adentan679/PinballMachine/hardware/cad/flipper_CAD.JPG

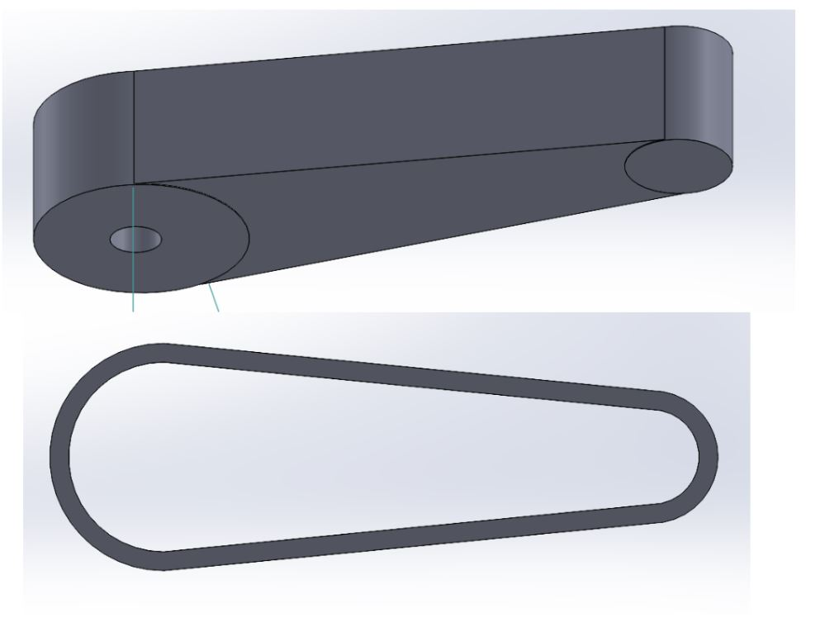
hardware/cad/flipper_CAD.JPG
