adentan679/PinballMachine/hardware/cad/flipper_design.JPG

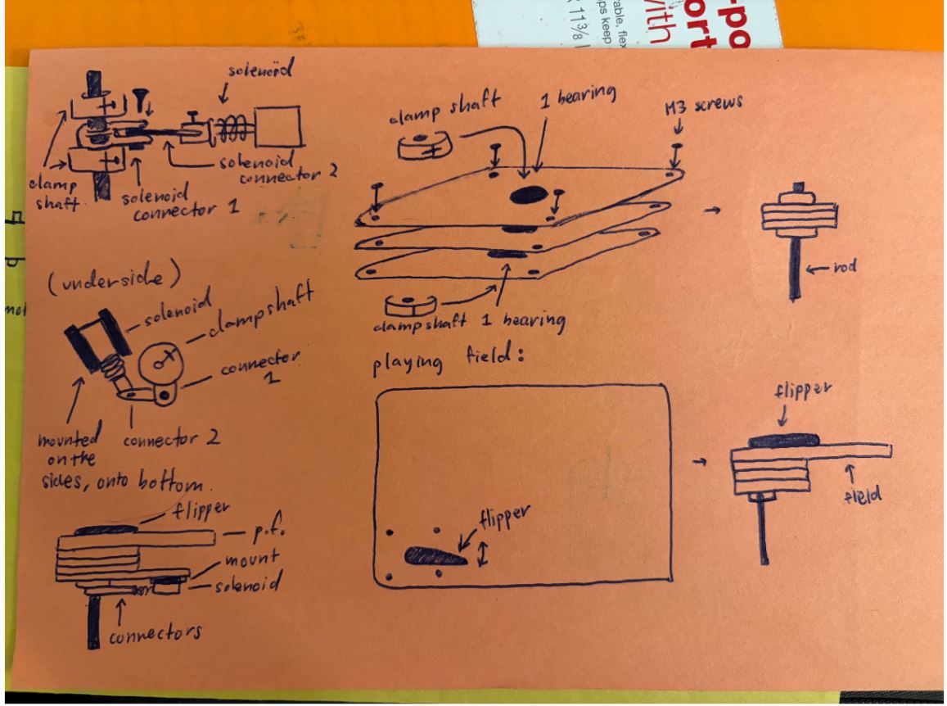
hardware/cad/flipper_design.JPG
