adentan679/PinballMachine/hardware/cad/full_cad_schematic.JPG

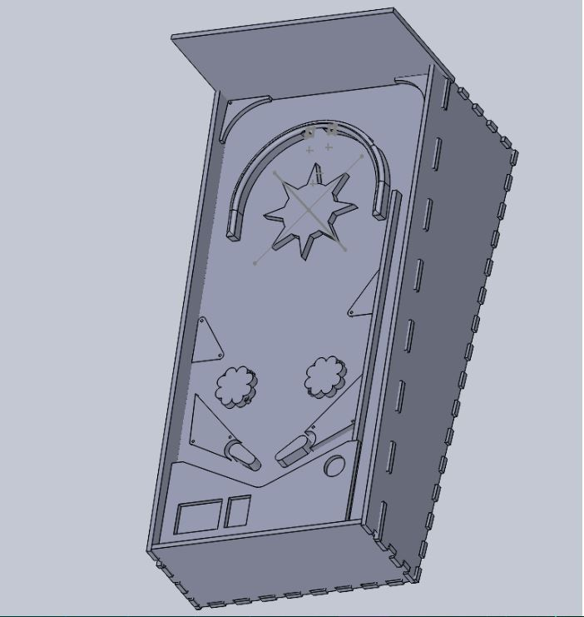
hardware/cad/full_cad_schematic.JPG
