adentan679/PinballMachine/hardware/cad/piezo_sensor_CAD.JPG

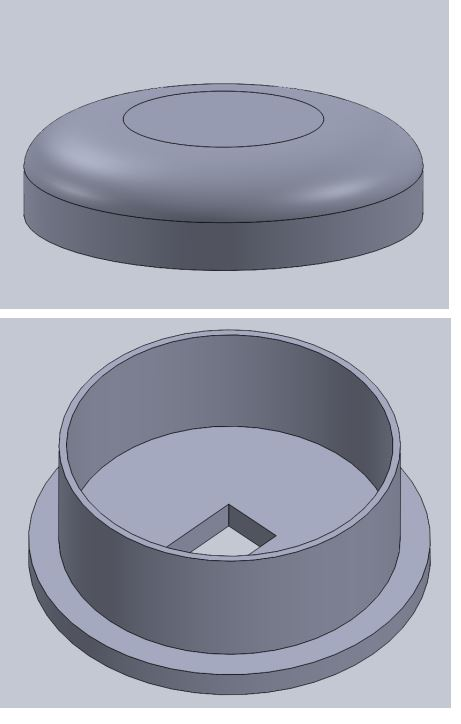
hardware/cad/piezo_sensor_CAD.JPG
