adentan679/PinballMachine/hardware/cad/solenoid_connection.JPG

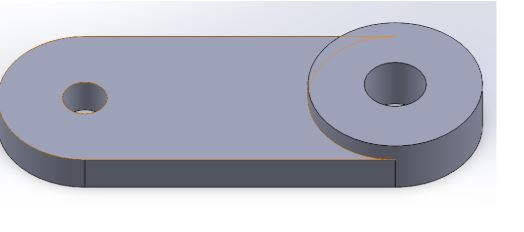
hardware/cad/solenoid_connection.JPG
