adentan679/PinballMachine/hardware/circuit_diagrams/gear_motor_diagram.JPG

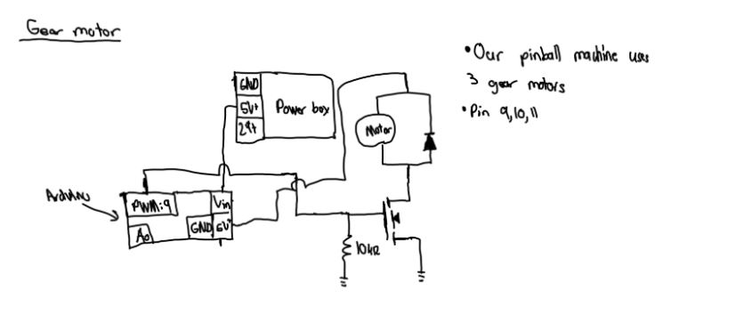
hardware/circuit_diagrams/gear_motor_diagram.JPG
