adentan679/PinballMachine/hardware/circuit_diagrams/IR_sensor_points_diagram.JPG

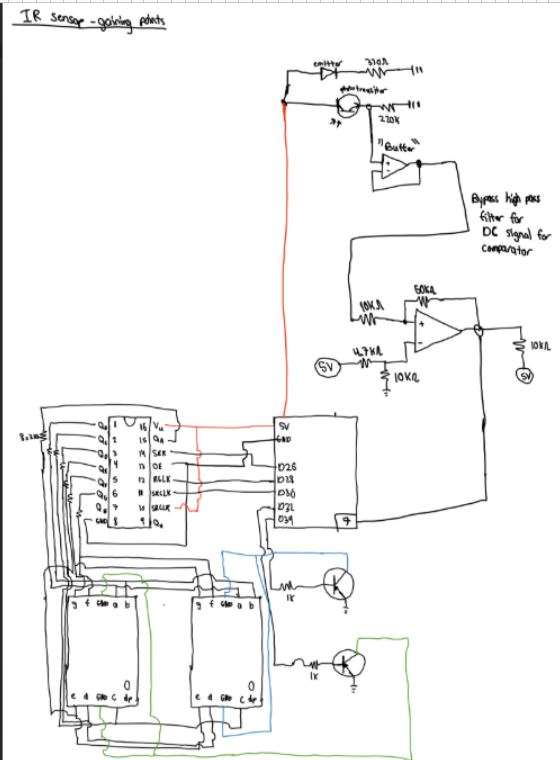
hardware/circuit_diagrams/IR_sensor_points_diagram.JPG
