adentan679/PinballMachine/hardware/circuit_diagrams/loss_sensor_diagram.JPG

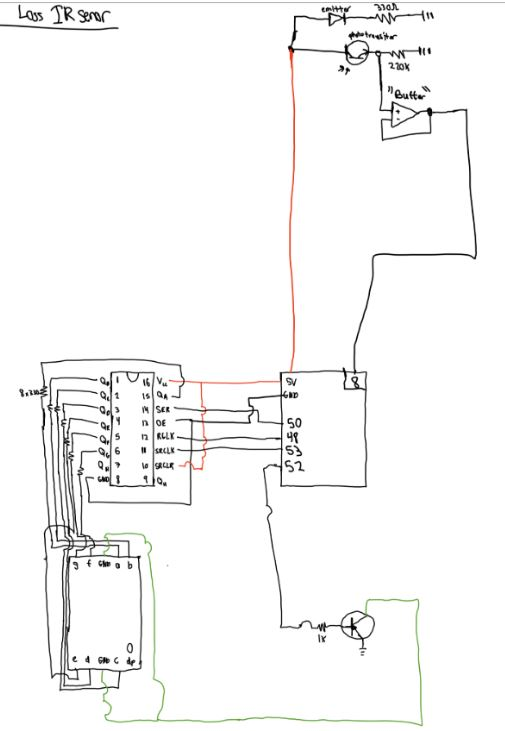
hardware/circuit_diagrams/loss_sensor_diagram.JPG
