adentan679/PinballMachine/hardware/circuit_diagrams/piezo_sensor_diagram.JPG

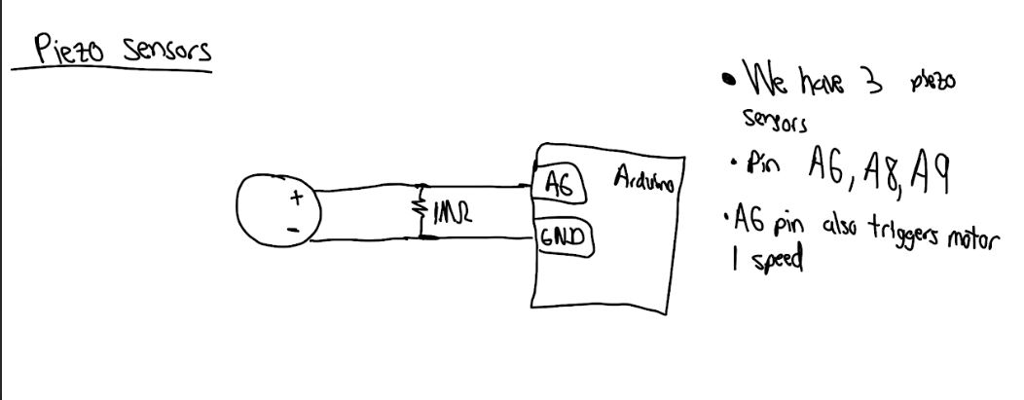
hardware/circuit_diagrams/piezo_sensor_diagram.JPG
