adentan679/PinballMachine/hardware/circuit_diagrams/servo_gate_diagram.JPG

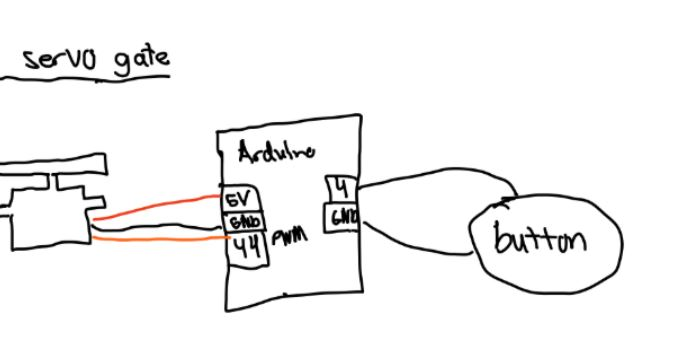
hardware/circuit_diagrams/servo_gate_diagram.JPG
