adentan679/PinballMachine/hardware/circuit_diagrams/solenoid_diagram.JPG

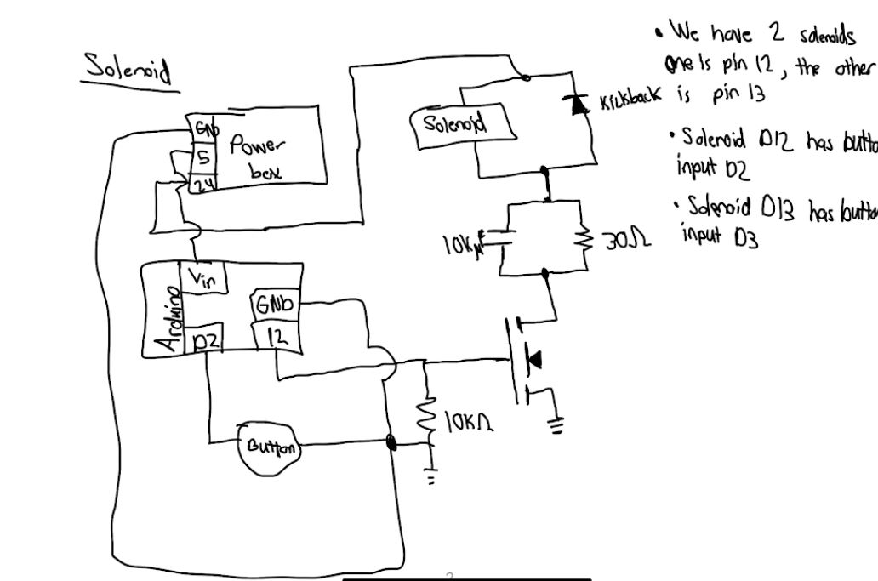
hardware/circuit_diagrams/solenoid_diagram.JPG
