adentan679/PinballMachine/media/final_project_pic.jpg

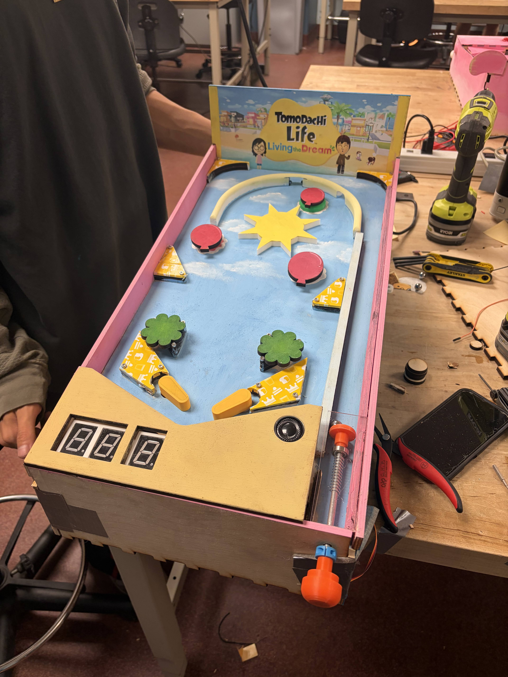
[picture p1: media/final_project_pic.jpg]
media/final_project_pic.jpg
