adentan679/PinballMachine/media/group_img.jpg

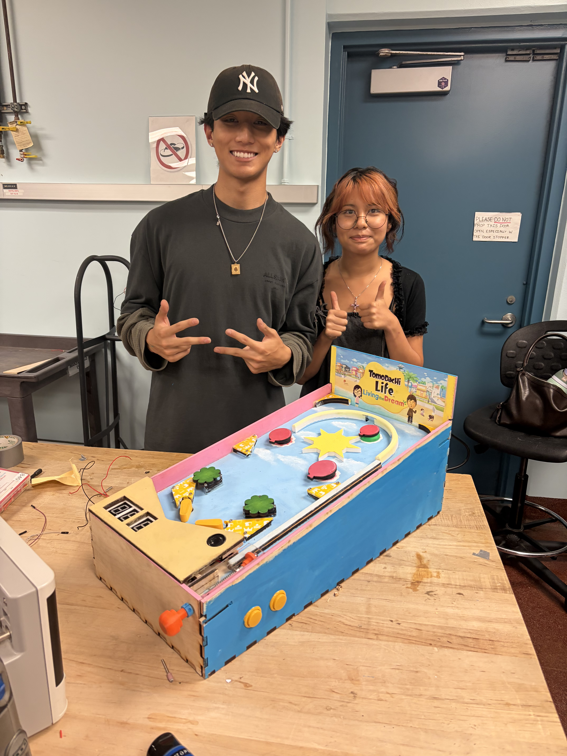
[picture p2: media/group_img.jpg]
media/group_img.jpg
